AmelieMuller/Robot-Papier-Ciseaux/README.md

# Robot-Papier-Ciseaux
Système permettant de jouer à pierre papier ciseaux contre un bras robotisé. 

Cahier des charges :
 * faire bouger la main robotisée afin de reproduire les mouvements pierre papier et ciseaux
   * fabriquer la main
   * la faire bouger
   * faire réaliser aléatoirement un mouvement entre pierre papier et ciseaux
 
 * capter et analyser les mouvements de l'utilisateur grâce à un gant connecté
    * créer un gant muni de potentiomètres
    * reconnaître les mouvements pierre papier et ciseaux faits par l'utilisateur
 
* déduire l'issu de la partie en comparant les deux mouvements
