AmelieMuller/Robot-Papier-Ciseaux/Compte rendu séances/Compte rendus Camille/Compte-Rendu Séance 8.pdf

Compte-Rendu Séance 8

Lors de cette dernière séance, j’ai pu remplacer les deux résistances qui avaient des faux contacts. Le gant est donc enfin terminé et fonctionnel, à une couture rapide de la résistance du pouce près.

Nous avons pu faire quelques essais et le projet dans son ensemble fonctionne comme prévu. Après avoir chacun peaufiné quelques détails comme le cablemanagement ou bien l’affichage de l’écran pour avoir un résultat plus esthétique, nous avons conclu que le projet était achevé.

Voici ci-dessous une photo du gant avec les nouvelles résistances et le cablemanagement.

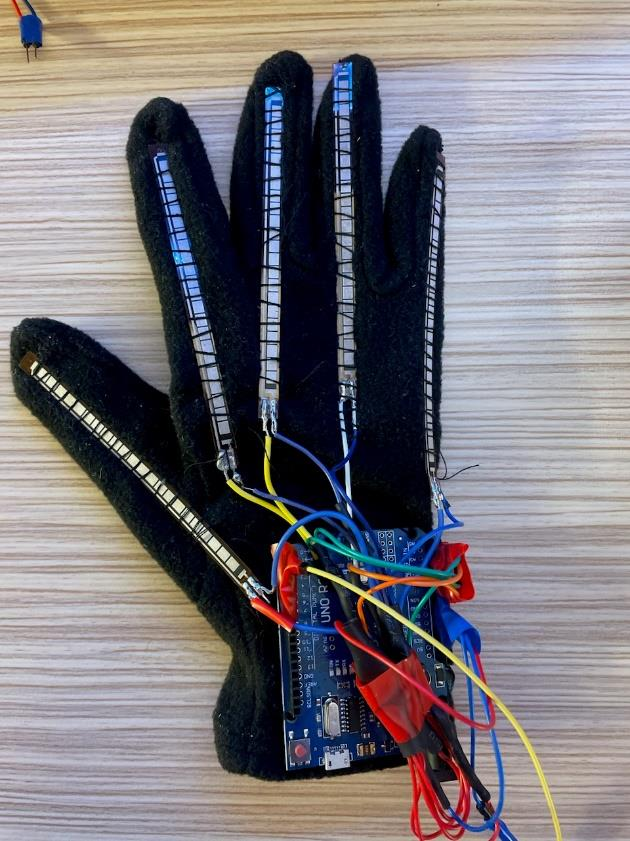
[picture p19: figure]
