AmelieMuller/Robot-Papier-Ciseaux/Codes/readme.md

Dans ce dossier se trouvent tous les codes nécessaires au projet
