AmelieMuller/Robot-Papier-Ciseaux/Planning.md

#Planning
* Séance 1
  * Recherche d'information sur la conception du gant et de la main (Camille/Amélie)
  * Recherche et commande du matériel adapté (Camille/Amélie)
  
* Séance 2:
  * Si présence du matériel:
    * Début du montage du gant (Camille) 
    * Début du montage de la main (Amélie)
  * Sinon:
    * Début de l'écriture du code pour la main (Amélie) et pour le gant (Camille)
 
* Séance 3:
  * idem

* Séance 4:
  * fin des montages 

* Séance 5-6:
  * Ecriture du code du jeu (Camille/Amélie)
 
* Séance 7-8:
  * Derniers réglages et tests
