AmelieMuller/Robot-Papier-Ciseaux/Compte rendu séances/Compte rendus Camille/Compte-Rendu Séance 4.pdf

Compte-Rendu Séance 4

Lors de cette séance, je n’ai malheureusement pas pu faire énormément de choses. En effet, dans l’attente de l’arrivée des cartes Bluetooth, la seule partie sur laquelle je peux m’attarder vraiment pour l’instant est en fait le gant et ses soudures. Cependant, le poste de soudure étant utilisé par de nombreuses personnes, et la soudure n’étant pas une activité que je pratique assez souvent pour être rapide et efficace, je n’ai pas pu améliorer énormément l’avancement du gant. J’ai cependant découvert qu’une microcoupure s’était probablement faite sur une des résistances flexibles. En effet, après avoir remarqué un faux contact sur l’une des résistances flexibles, j’ai pu utiliser un voltmètre afin de vérifier d’où provenait le faux contact. J’attends toujours de pouvoir disposer de toutes mes résistances en bon état afin de pouvoir assembler complètement le gant et de passer, enfin, à la partie logique du programme. Il est cependant important de noter que nous avons déjà une claire idée de la manière dont nous comptons procéder.
