AmelieMuller/Robot-Papier-Ciseaux/Compte rendu séances/Compte rendus Camille/Compte-Rendu Seance 3.pdf

Compte-Rendu Séance 3

Pendant cette séance, je me suis d’abord penché sur l’envoi du signe effectué par l’utilisateur à la deuxième carte Arduino. Cependant, la majorité de ma séance était basée sur la soudure des résistances flexibles. J’ai d’abord vérifié mon montage puis ai demandé à ce qu’on m’apprenne comment souder. Mes soudures (étant les premières que je fais) ne sont donc pas élégantes, mais elles remplissent leur fonction. J’ai malheureusement abimé la piste d’une des résistances, j’attends donc de savoir si cela sera réparable. Je suis plus tard retourné au fablab pour finir de souder la dernière résistance (sans compter celle abîmée). Il ne reste plus qu’à souder les câbles récupérant le courant à un câble pouvant se connecter à l’Arduino, et de même pour les câbles allant vers la masse.

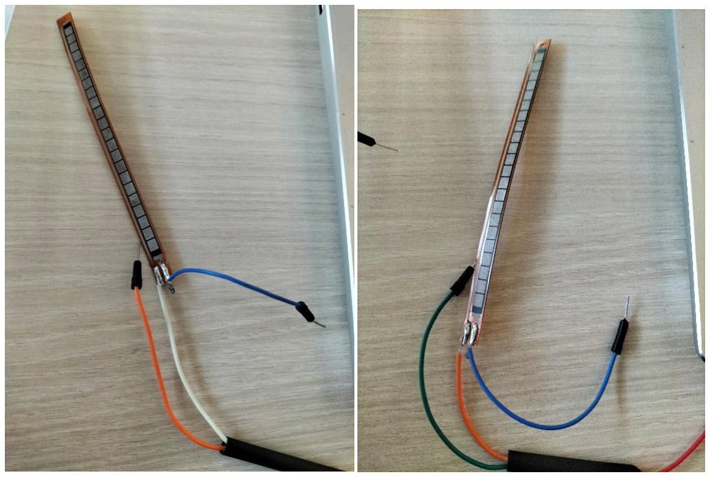
[picture p36: figure]
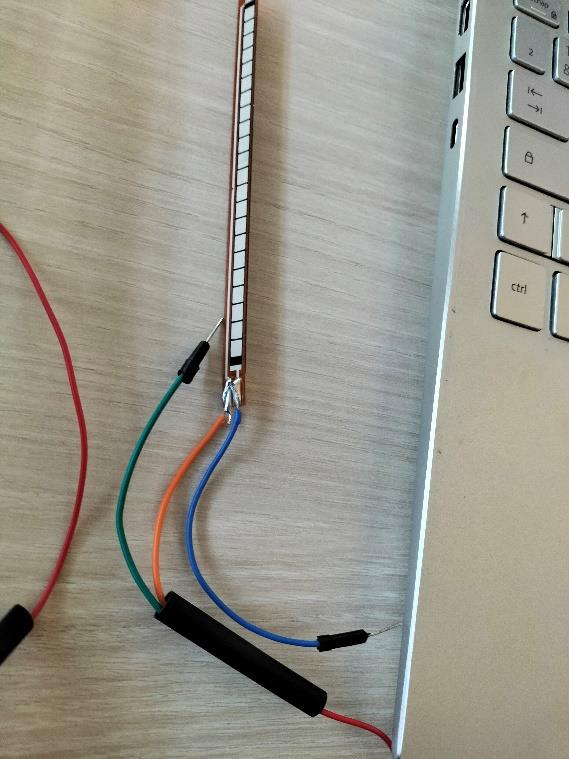
[picture p37: figure]
