AmelieMuller/Robot-Papier-Ciseaux/Robot Papier Ciseaux.pdf

# Robot Papier Ciseaux

CAMILLE ANTONIOS ET AMELIE MULLER

01

# Concept du projet

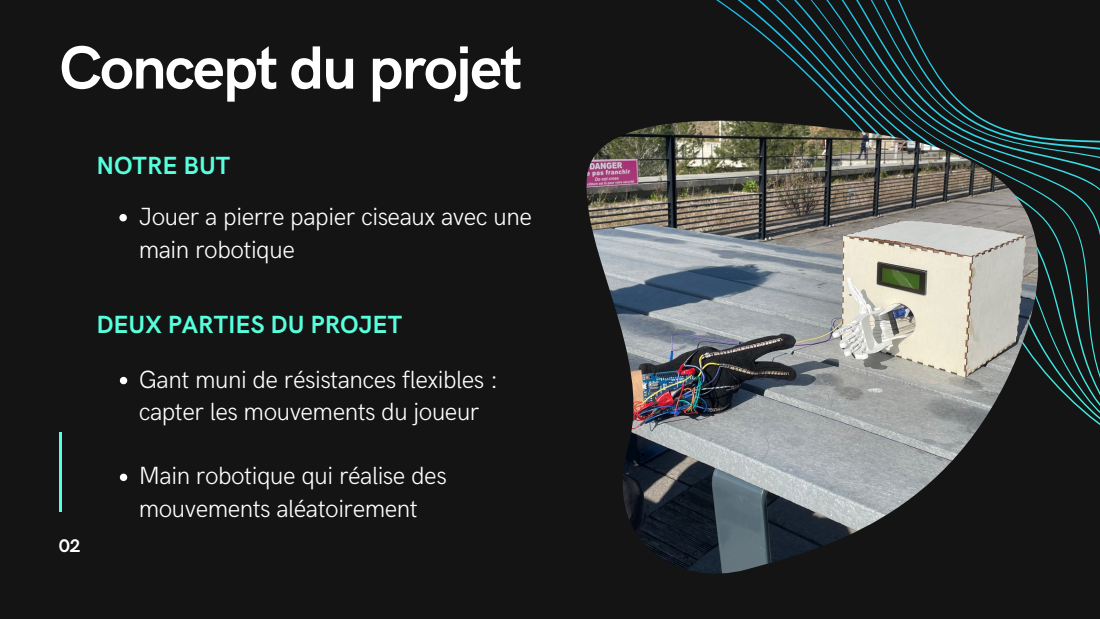
[picture p38: page 2]

NOTRE BUT
Jouer a pierre papier ciseaux avec une
main robotique

DEUX PARTIES DU PROJET

Gant muni de résistances flexibles :
capter les mouvements du joueur

Main robotique qui réalise des
mouvements aléatoirement

# Circuit complet

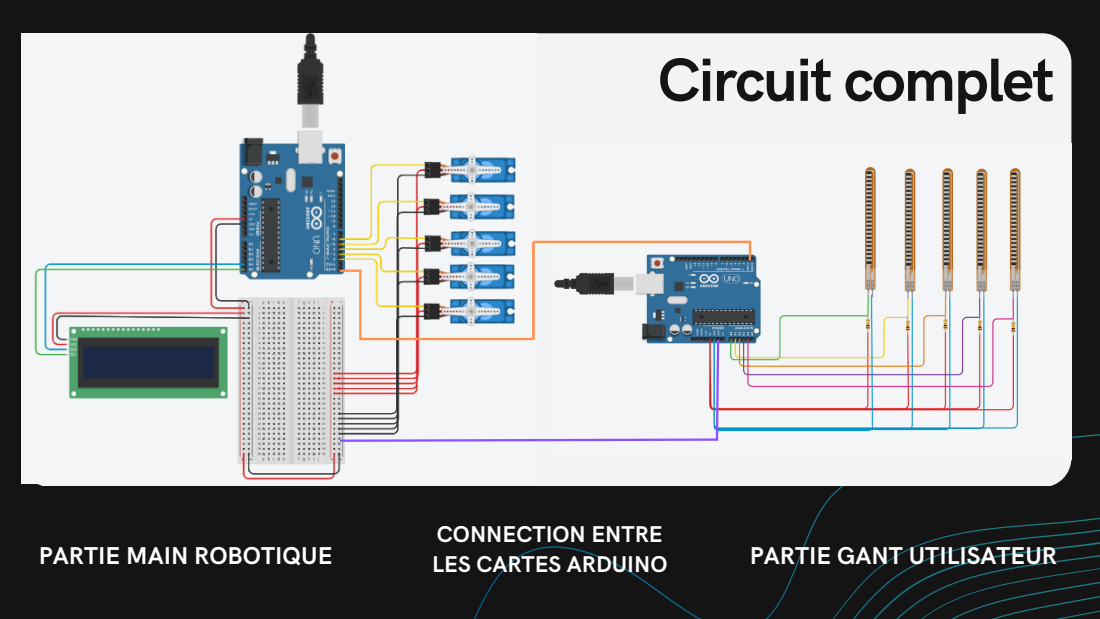
[picture p39: page 3]
CONNECTION ENTRE; LES CARTES ARDUINO; PARTIE GANT UTILISATEUR

PARTIE MAIN ROBOTIQUE

# Partie Gant Utilisateur

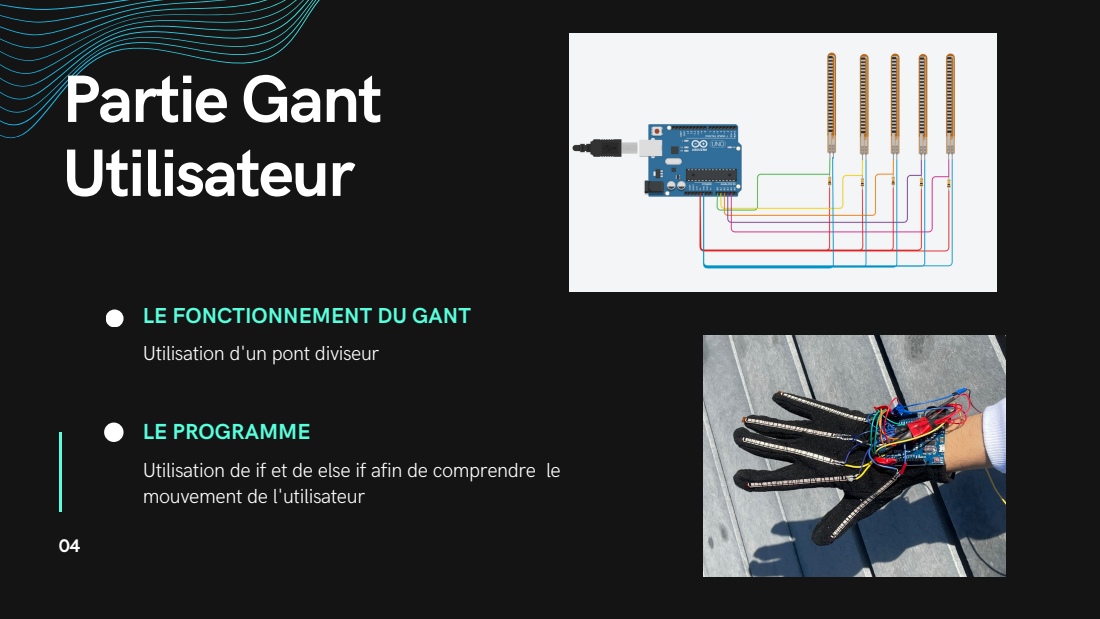
[picture p40: page 4]
utilisateur

LE FONCTIONNEMENT DU GANT
Utilisation d'

un pont diviseur

LE PROGRAMME
Utilisation de if et de else if afin de comprendre le
mouvement de l'

# Partie Main Robotique

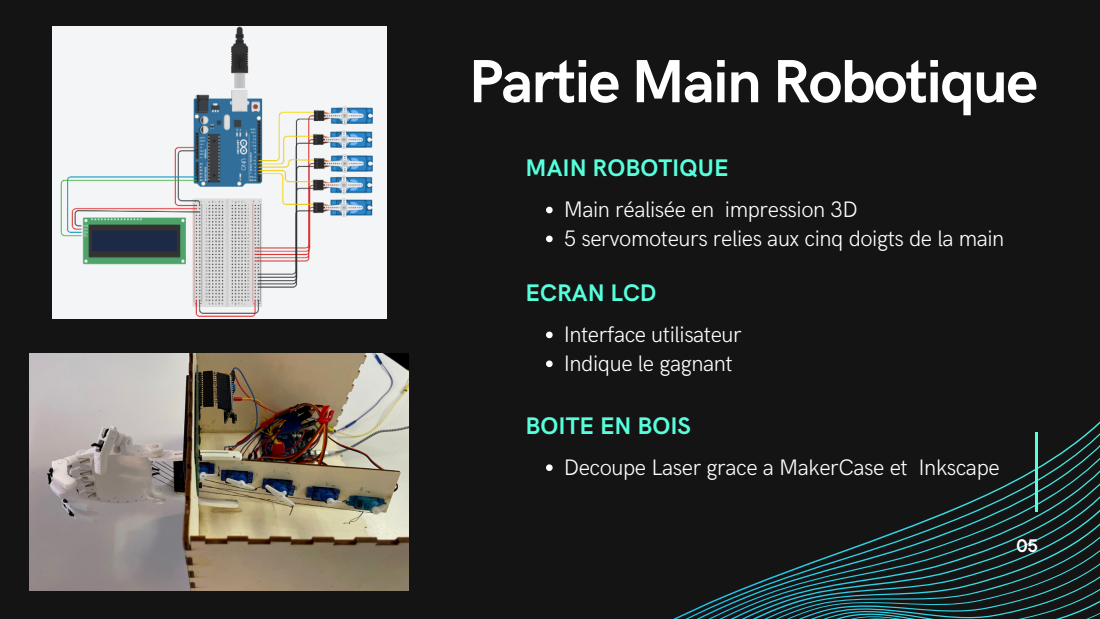
[picture p41: page 5]

MAIN ROBOTIQUE
Main réalisée en impression 3D
5 servomoteurs relies aux cinq doigts de la main

ECRAN LCD
Interface utilisateur
Indique le gagnant

BOITE EN BOIS
Decoupe Laser grace a MakerCase et Inkscape

# Démonstration

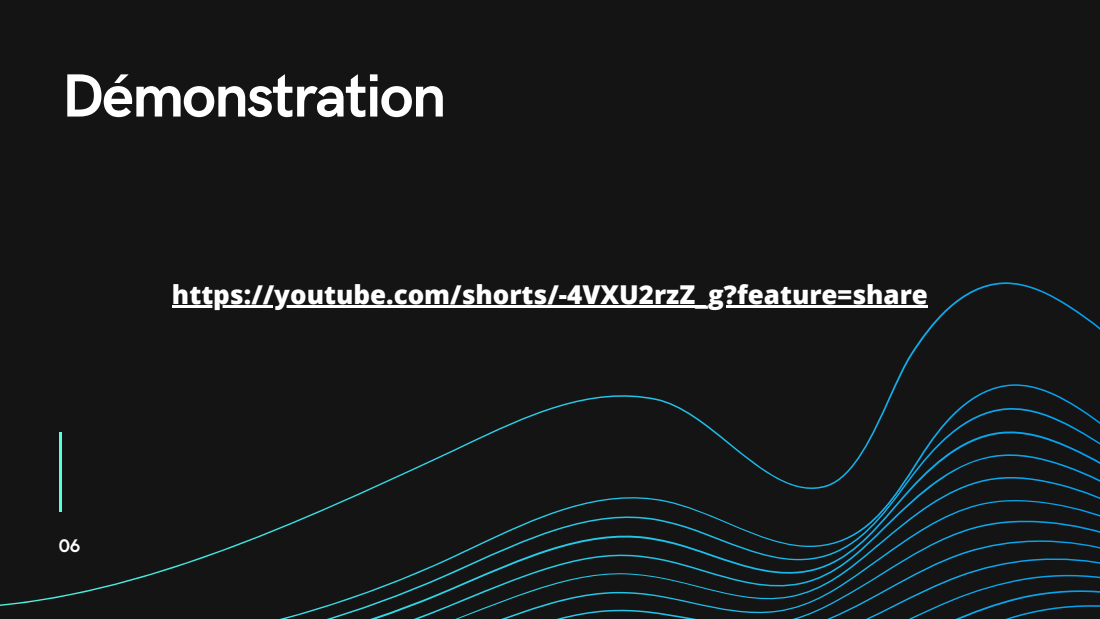
[picture p42: page 6]

https://youtube.com/shorts/-4VXU2rzZ_g?feature=share

# Apports du projet

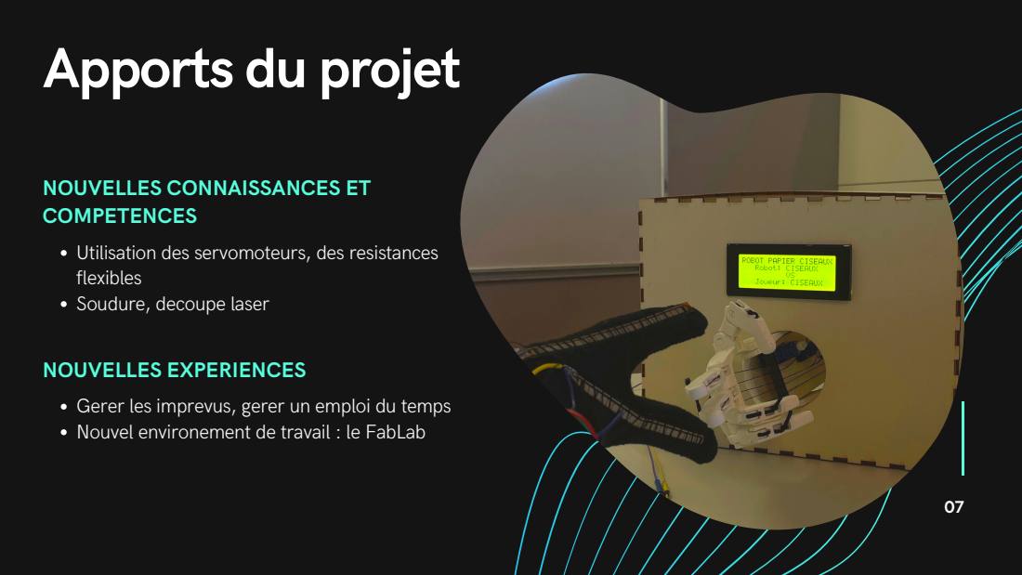
[picture p43: page 7]

NOUVELLES CONNAISSANCES ET
COMPETENCES
Utilisation des servomoteurs, des resistances
flexibles
Soudure, decoupe laser

NOUVELLES EXPERIENCES
Gerer les imprevus, gerer un emploi du temps
Nouvel environement de travail : le FabLab
